Monolithcreative/ES4D/ES4D-2UC.png

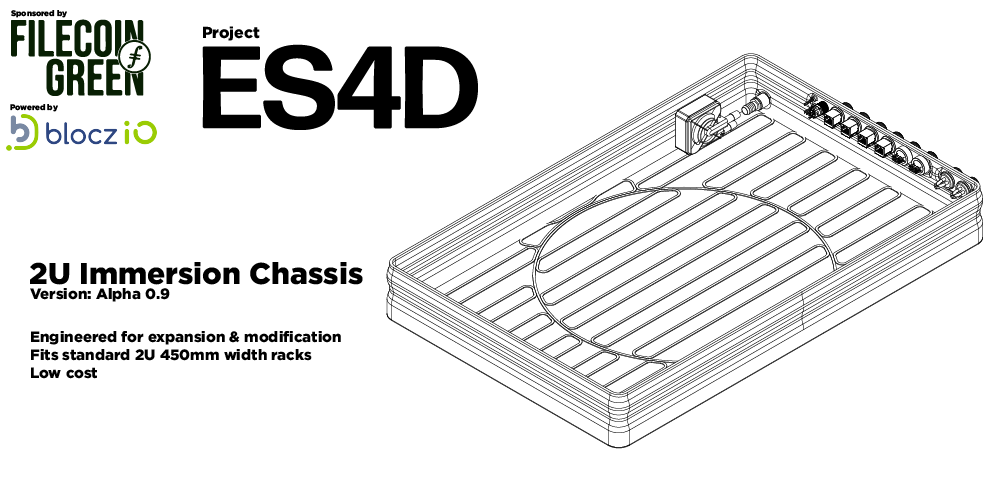
ES4D-2UC.png
