Monolithcreative/ES4D/ES4D-8UR.png

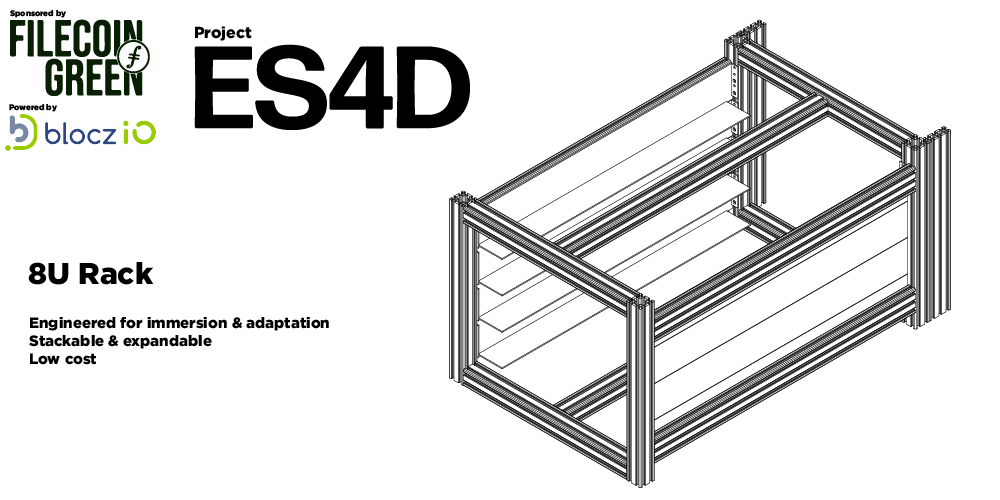
ES4D-8UR.png
