Monolithcreative/ES4D/ES4D.png

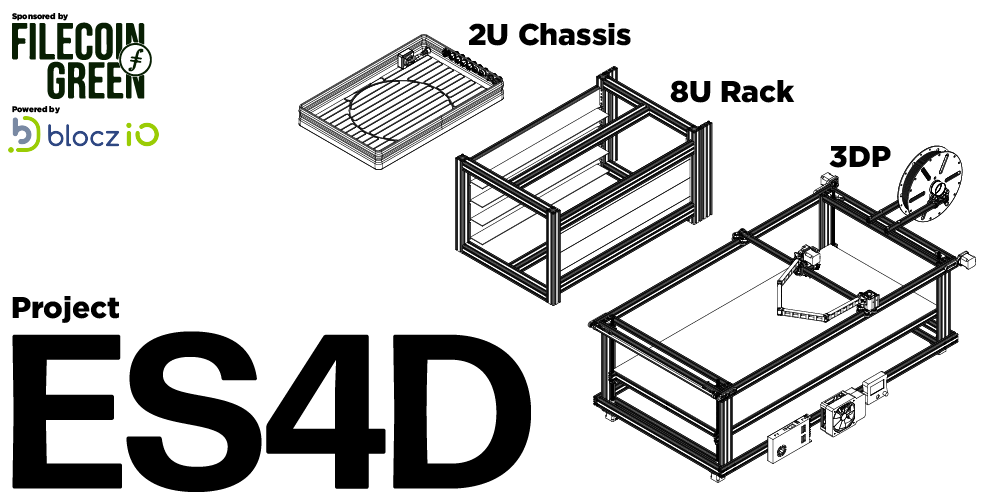
ES4D.png
