Monolithcreative/ES4D/ES4D_3DP_V1.1_BOM.pdf

ES4D 3DP V2 Bill of Materials - Server Chassis Printer

Mechanical (Scalable) | Size (mm)/Desc.
Alu 2020 | 300 | Ooznest (https://ooznest.co.uk/product/v-slot-linear-rail-20x20mm-cut-to-size/) | £ | 2.33 | 2 £ | 4.66
Alu 2020 | 626 | Ooznest (https://ooznest.co.uk/product/v-slot-linear-rail-20x20mm-cut-to-size/) | £ | 5.41 | 4 £ 21.64
Alu 2020 | 670 | Ooznest (https://ooznest.co.uk/product/v-slot-linear-rail-20x20mm-cut-to-size/) | £ | 5.79 | 1 £ | 5.79
Alu 2040 | 560 | Ooznest (https://ooznest.co.uk/product/v-slot-linear-rail-20x40mm-cut-to-size/) | £ | 7.06 | 2 £ 14.12
Alu 2040 | 666 | Ooznest (https://ooznest.co.uk/product/v-slot-linear-rail-20x40mm-cut-to-size/) | £ 10.07 | 4 £ 40.28
Alu 2040 | 1240 | Ooznest (https://ooznest.co.uk/product/v-slot-linear-rail-20x40mm-cut-to-size/) | £ 18.75 | 2 £ 37.50
Alu 2040 | 1300 | Ooznest (https://ooznest.co.uk/product/v-slot-linear-rail-20x40mm-cut-to-size/) | £ 19.66 | 2 £ 39.32
Alu 2060 | 400 | Ooznest (https://ooznest.co.uk/product/v-slot-linear-rail-20x60mm-cut-to-size/) | £ | 8.06 | 4 £ 32.24
Alu rod | 730 x 8 | DIY Store | £ 12.00 | 1 £ 12.00
Buildplate | 1200 x 500 x 4 | Matals4U (https://www.metals4u.co.uk/materials/aluminium/aluminium-sheet/aluminium-mill-finish-aluminium-sheet/9069-p) £ 71.96 | 2 £ 143.92
£ 351.47
Electrical
Contoller | Amazon (https://www.amazon.co.uk/dp/B094NG4D17?s=computers&sp_csd=d2lkZ2V0TmFtZT1zcF9kZXRhaWw) | £ 59.99 | 1 £ 59.99
LCD Screen | Amazon (https://www.amazon.co.uk/BIGTREETECH-Mini12864-intelligent-backlight-suitable/dp/B08N693VQN) | £ 24.99 | 1 £ 24.99
4pcs Stepper Drivers | Amazon (https://www.amazon.co.uk/KINGPRINT-TMC5160-Stepper-StepStick-Heatsink/dp/B07Q1HRN17) | £ 68.99 | 2 £ 137.98
5pcs Nema17 2A Motors | Amazon (https://www.amazon.co.uk/Beautystar-Stepper-Bipolar-Mounting-Brackets/dp/B075SYWFJM) | £ 46.99 | 2 £ 93.98
Power Supply | 12V 1000W | Amazon (https://www.amazon.co.uk/MOGOULUA-Switching-1000W-12V-Transformer/dp/B09Y5DKV6B?s=industrial) | £ 59.99 | 1 £ 59.99
2pcs Lead Screws | Amazon (https://www.amazon.co.uk/iYueshare-100mm-800mm-Printer-Linear/dp/B099WGDWW3) | £ 19.99 | 1 £ 19.99
Belt | Amazon (https://www.amazon.co.uk/gp/product/B07YD5SBD9/ref=ppx_yo_dt_b_search_asin_title?ie=UTF8&psc=1) | £ 13.98 | 2 £ 27.96
5mm Pulley Gear | 20T | Amazon (https://www.amazon.co.uk/Saipor-Aluminum-Synchronous-Compatible-Printer/dp/B084KLTS84) | £ | 6.49 | 1 £ | 6.49
8mm Pulley Gear | 40T | Amazon (https://www.amazon.co.uk/Timing-Pulley-Synchronous-Aluminium-Printer/dp/B07X6M45DJ?s=industrial) | £ | 7.59 | 1 £ | 7.59
8mm Pulley Gear | 60T | Amazon (https://www.amazon.co.uk/sourcing-map-Aluminium-Synchronous-Printer/dp/B09VPR1N1S) | £ | 6.93 | 4 £ 27.72
10pcs Endstops | Amazon (https://www.amazon.co.uk/dp/B08XNG49MW?s=diy&sp_csd=d2lkZ2V0TmFtZT1zcF9kZXRhaWw) | £ 13.99 | 1 £ 13.99
Spacers | Amazon (https://www.amazon.co.uk/dp/B08FRJSQ3Q?s=industrial&sp_csd=d2lkZ2V0TmFtZT1zcF9kZXRhaWwy) | £ 11.99 | 1 £ 11.99
Coupler | Amazon (https://www.amazon.co.uk/UniTak3D-Coupler-Coupling-Printer-Machine/dp/B096G1GZH5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) | £ 11.98 | 2 £ 23.96
Hotend | Amazon (https://www.amazon.co.uk/dp/B0BQYR2TPV/?coliid=I2QIFLH1Q9VK75&colid=2YCJ0P2LP918P) | £ 51.91 | 1 £ 51.91
Mount | Amazon (https://www.amazon.co.uk/dp/B09B2LPBJF/?coliid=IIJJVT6UKROH8&colid=2YCJ0P2LP918P) | £ 14.99 | 1 £ 14.99
Geabox | Amazon (https://www.amazon.co.uk/dp/B07W6SW4TN?s=industrial&sp_csd=d2lkZ2V0TmFtZT1zcF9kZXRhaWw) | £ 11.89 | 1 £ 11.89
PID Temp Controller | Amazon (https://www.amazon.co.uk/gp/product/B07N4K2J2N/ref=ppx_yo_dt_b_asin_title_o00_s00?ie=UTF8&psc=1) | £ 22.69 | 1 £ 22.69
Heater Pad | Amazon (https://www.amazon.co.uk/dp/B07RHGXWDZ?s=industrial&sp_csd=d2lkZ2V0TmFtZT1zcF9kZXRhaWw) | £ 26.19 | 2 £ 52.38
£ 670.48

3D Printed
40mm Turbo Fan Mount | | | £ | 0.34 | 1 £ | 0.34
Bearing Holder 2 | | | £ | 0.06 | 4 £ | 0.24
Bearing Z_L | | | £ | 0.12 | 2 £ | 0.24
Bearing Z_R | | | £ | 0.12 | 2 £ | 0.24
Cable Chain Connector 1 | | | £ | 0.06 | 1 £ | 0.06
Cable Chain Connector 2 | | | £ | 0.07 | 1 £ | 0.07
Cable Chain Long | | | £ | 0.36 | 4 £ | 1.44
Controller Case A | | | £ | 1.59 | 1 £ | 1.59
Controller Case B | | | £ | 1.02 | 1 £ | 1.02
End Bearing Holder A | | | £ | 0.14 | 2 £ | 0.28
End Bearing Holder B | | | £ | 0.13 | 2 £ | 0.26
Extruder A | | | £ | 0.71 | 1 £ | 0.71
Extruder B | | | £ | 0.56 | 1 £ | 0.56
Gantry X | | | £ | 0.30 | 1 £ | 0.30
Gantry X 2 | | | £ | 0.29 | 1 £ | 0.29
Motor Mount | | | £ | 0.75 | 1 £ | 0.75
Motor Mount 2 | | | £ | 0.33 | 1 £ | 0.33
Motor Mount Z_L | | | £ | 0.34 | 2 £ | 0.68
Motor Mount Z_R | | | £ | 0.34 | 2 £ | 0.68
Reel Roll | | | £ | 0.90 | 1 £ | 0.90
Reel Roller Side | | | £ | 0.26 | 4 £ | 1.04
Z Spacer | | | £ | 0.05 | 4 £ | 0.20
£ 12.22

Total £ 1,034.17
