Monolithcreative/ES4D/3DP V1.1 Solidworks Files/ES4DReprap_Discount_Full_Graphic_Smart_Controller.SLDPRT

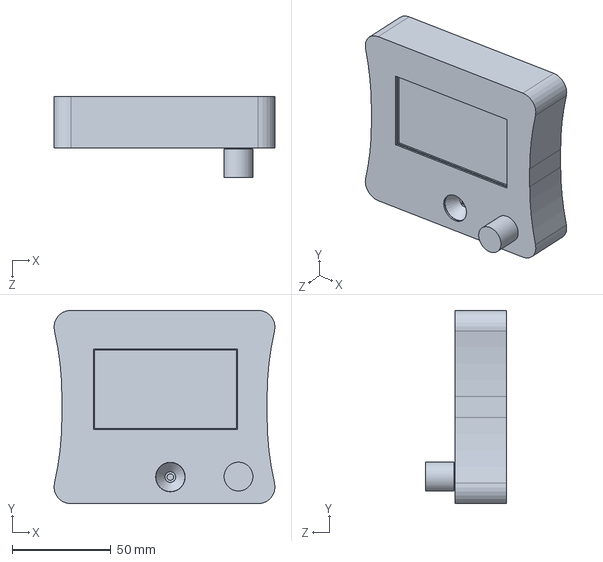
[picture p5: CAD file, 2023-10-12]
3DP V1.1 Solidworks Files/ES4DReprap_Discount_Full_Graphic_Smart_Controller.SLDPRT
112.0 x 98.0 x 41.0 mm
