Monolithcreative/ES4D/3DP V1.1 Solidworks Files/ES4DWheel.SLDPRT

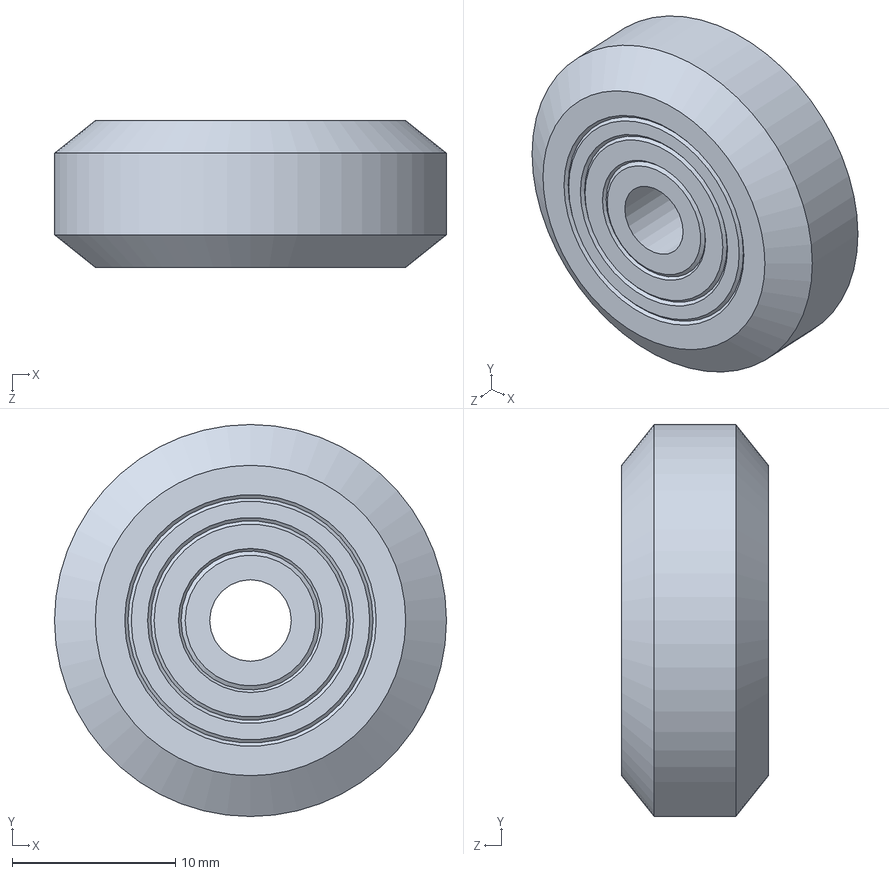
[picture p6: CAD file, 2023-10-12]
3DP V1.1 Solidworks Files/ES4DWheel.SLDPRT
24.0 x 24.0 x 9.00 mm
