Monolithcreative/ES4D/3DP V1.1 Solidworks Files/ES4DZ Spacer.SLDPRT

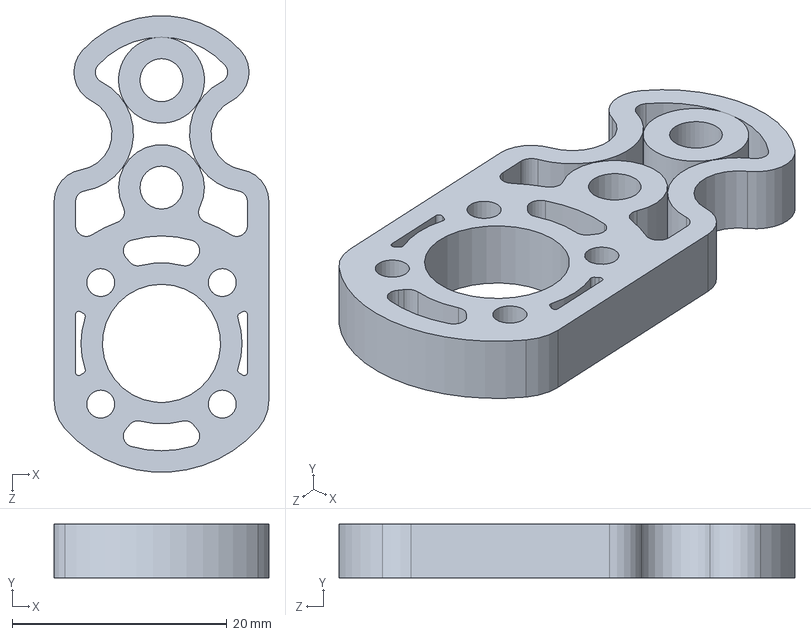
[picture p7: CAD file, 2023-10-12]
3DP V1.1 Solidworks Files/ES4DZ Spacer.SLDPRT
20.0 x 5.00 x 42.4 mm
