Monolithcreative/ES4D/3DP V1.1 Solidworks Files/ES4D600 x 1200 Alu plate.SLDPRT

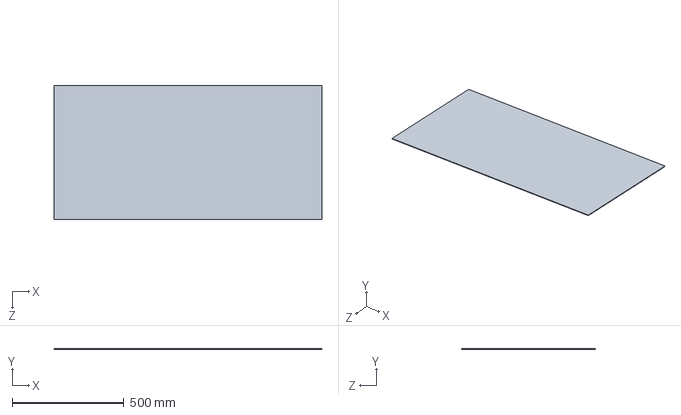
[picture p8: CAD file, 2023-10-12]
3DP V1.1 Solidworks Files/ES4D600 x 1200 Alu plate.SLDPRT
1200.0 x 3.00 x 600.0 mm
