Monolithcreative/ES4D/3DP V1.1 Solidworks Files/ES4DCable Chain Connector 2.SLDPRT

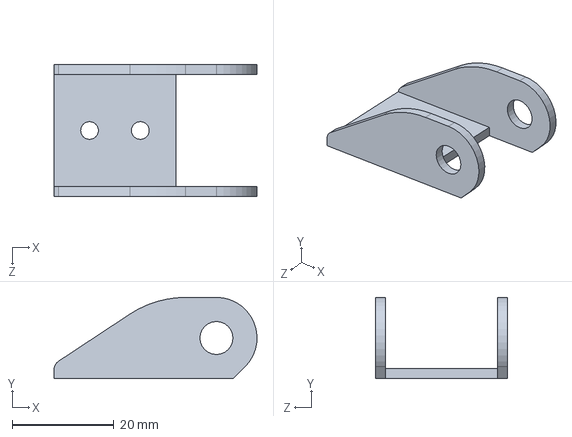
[picture p9: CAD file, 2023-10-12]
3DP V1.1 Solidworks Files/ES4DCable Chain Connector 2.SLDPRT
40.0 x 16.0 x 26.0 mm
