Monolithcreative/ES4D/3DP V1.1 Solidworks Files/ES4DExtruder gearbox.SLDPRT

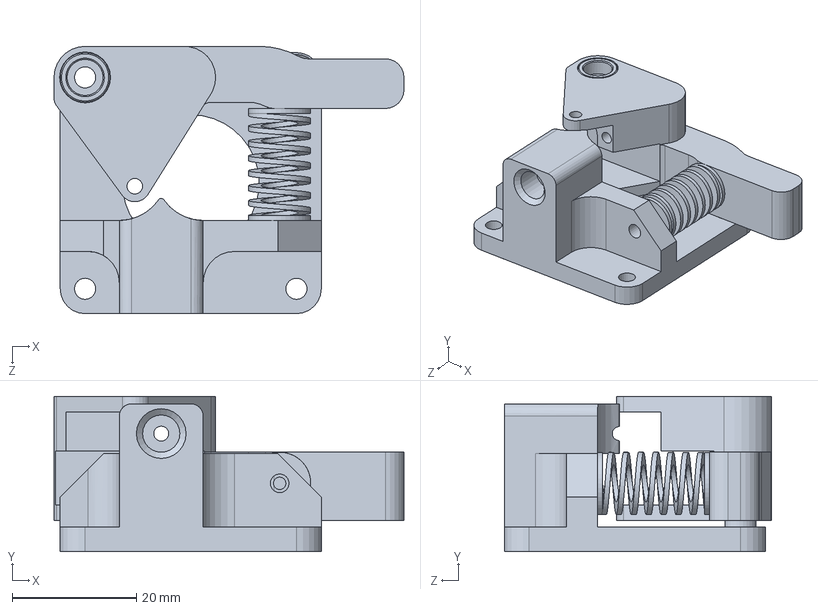
[picture p10: CAD file, 2023-10-12]
3DP V1.1 Solidworks Files/ES4DExtruder gearbox.SLDPRT
56.3 x 25.0 x 43.0 mm
