Monolithcreative/ES4D/3DP V1.1 Solidworks Files/ES4DMotor mount.SLDPRT

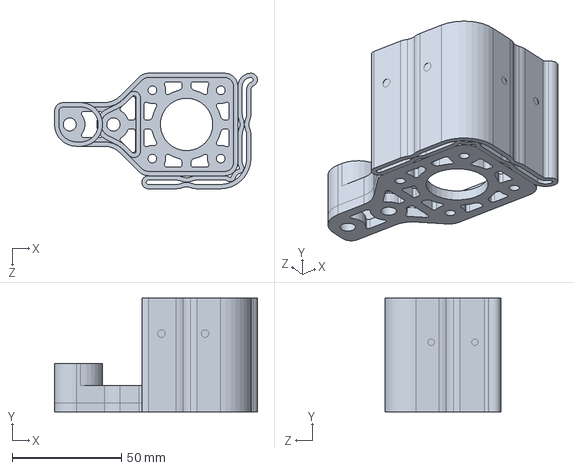
[picture p11: CAD file, 2023-10-12]
3DP V1.1 Solidworks Files/ES4DMotor mount.SLDPRT
93.0 x 52.0 x 53.0 mm
