Monolithcreative/ES4D/3DP V1.1 Solidworks Files/ES4DCable Chain Connector 1.SLDPRT

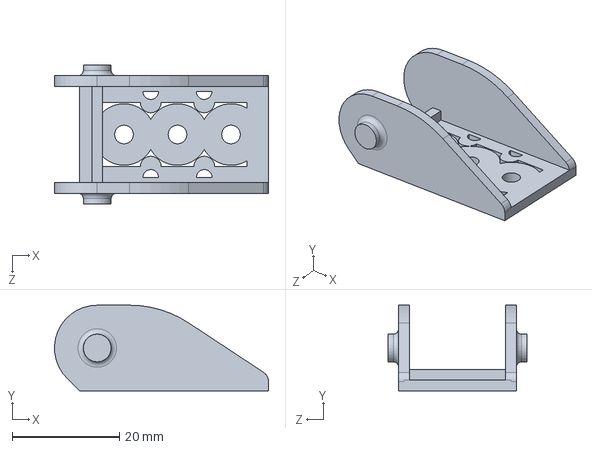
[picture p12: CAD file, 2023-10-12]
3DP V1.1 Solidworks Files/ES4DCable Chain Connector 1.SLDPRT
40.0 x 16.0 x 26.0 mm
