Monolithcreative/ES4D/3DP V1.1 Solidworks Files/ES4DPulley roller.SLDPRT

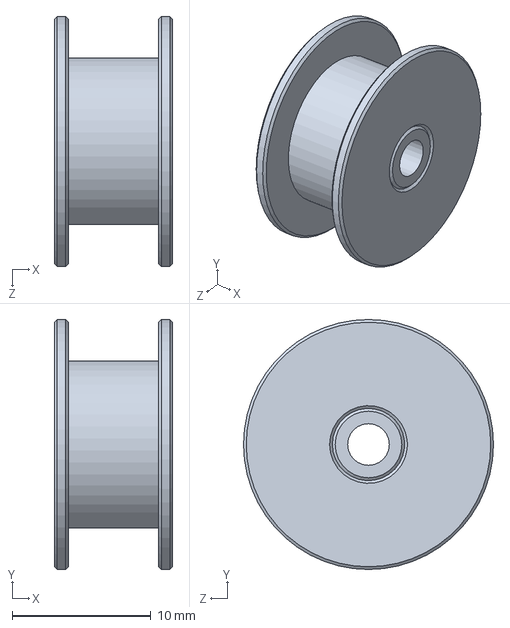
[picture p13: CAD file, 2023-10-12]
3DP V1.1 Solidworks Files/ES4DPulley roller.SLDPRT
8.50 x 18.0 x 18.0 mm
