Monolithcreative/ES4D/3DP V1.1 Solidworks Files/ES4DGantry X 2.SLDPRT

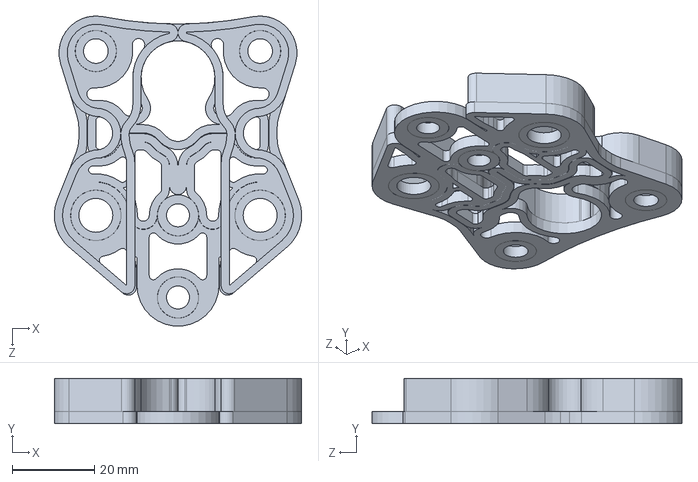
[picture p14: CAD file, 2023-10-12]
3DP V1.1 Solidworks Files/ES4DGantry X 2.SLDPRT
60.2 x 11.0 x 75.5 mm
