Monolithcreative/ES4D/3DP V1.1 Solidworks Files/ES4DCable Chain Long.SLDPRT

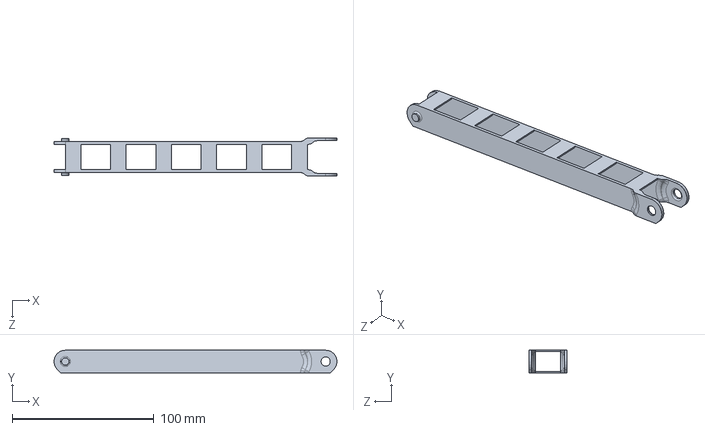
[picture p16: CAD file, 2023-10-12]
3DP V1.1 Solidworks Files/ES4DCable Chain Long.SLDPRT
200.0 x 16.0 x 27.0 mm
