Monolithcreative/ES4D/3DP V1.1 Solidworks Files/ES4D2060 x 400.SLDPRT

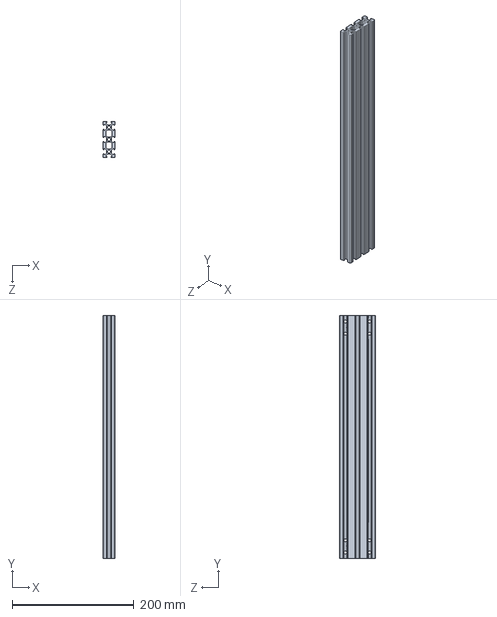
[picture p18: CAD file, 2023-10-12]
3DP V1.1 Solidworks Files/ES4D2060 x 400.SLDPRT
20.0 x 400.0 x 60.0 mm
