Monolithcreative/ES4D/3DP V1.1 Solidworks Files/ES4DEnd Bearing Holder.SLDPRT

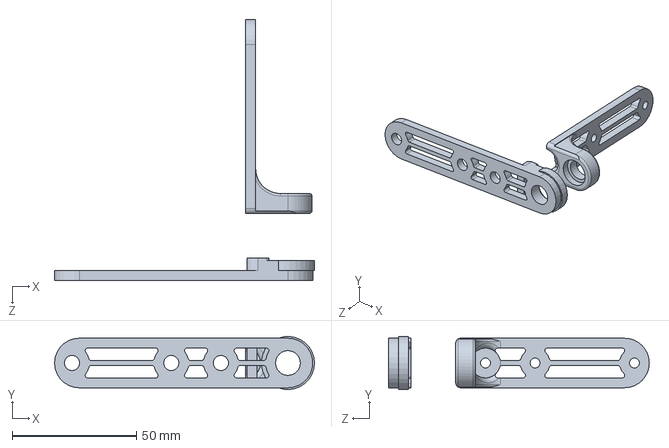
[picture p19: CAD file, 2023-10-12]
3DP V1.1 Solidworks Files/ES4DEnd Bearing Holder.SLDPRT
104.8 x 21.4 x 105.0 mm
