Monolithcreative/ES4D/3DP V1.1 Solidworks Files/ES4D2.3kg reel roller.SLDPRT

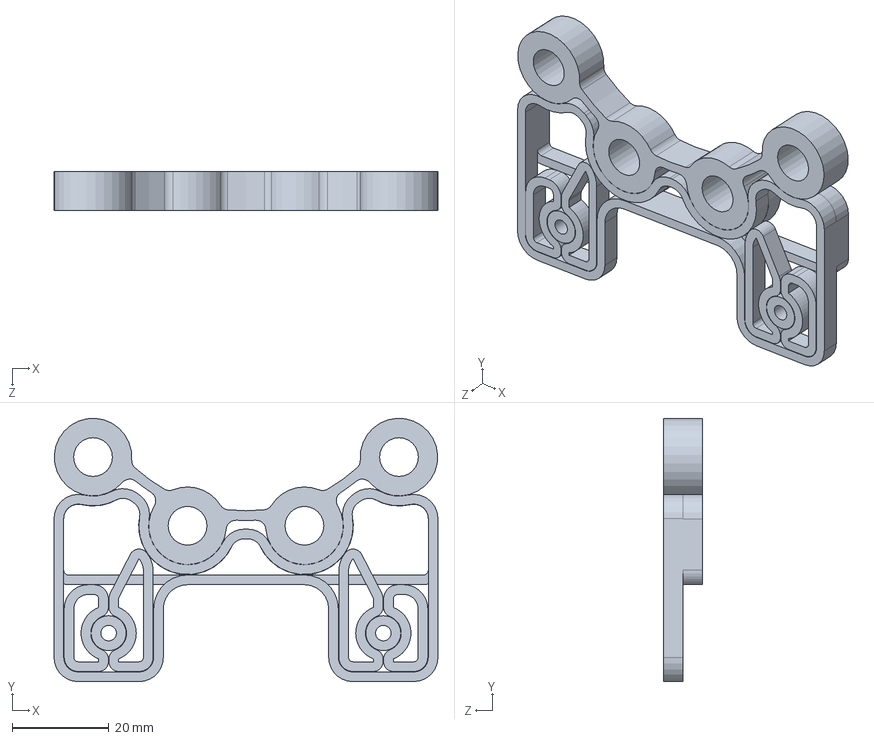
[picture p20: CAD file, 2023-10-12]
3DP V1.1 Solidworks Files/ES4D2.3kg reel roller.SLDPRT
79.2 x 54.3 x 8.00 mm
