Monolithcreative/ES4D/3DP V1.1 Solidworks Files/ES4Dreel roll.sldprt

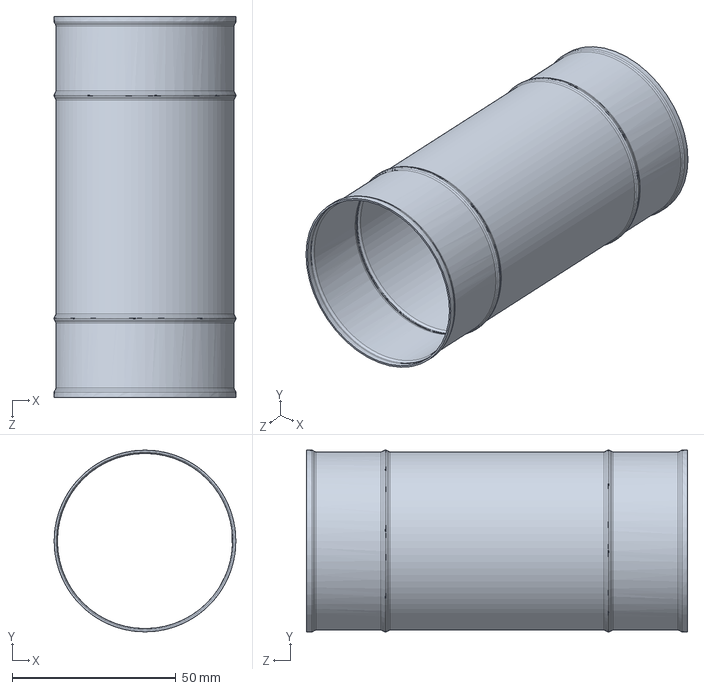
[picture p21: CAD file, 2023-10-12]
3DP V1.1 Solidworks Files/ES4Dreel roll.sldprt
55.4 x 55.4 x 116.2 mm
