Monolithcreative/ES4D/3DP V1.1 Solidworks Files/ES4DGear B.SLDPRT

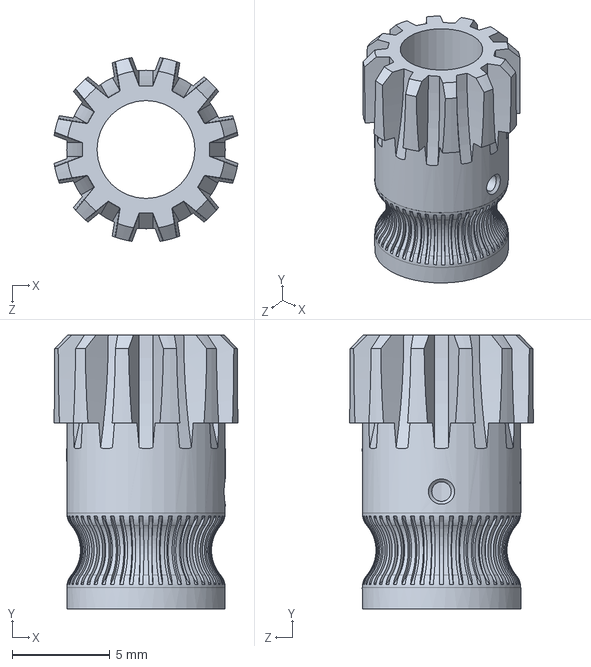
[picture p22: CAD file, 2023-10-12]
3DP V1.1 Solidworks Files/ES4DGear B.SLDPRT
9.39 x 14.0 x 9.39 mm
