Monolithcreative/ES4D/3DP V1.1 Solidworks Files/ES4DExtruder.SLDPRT

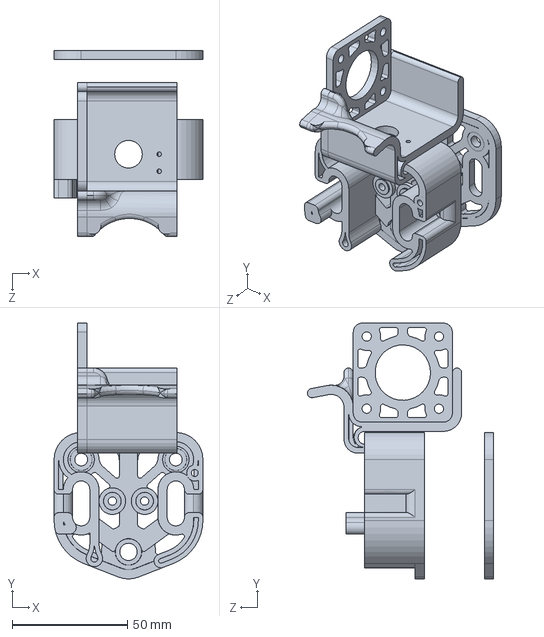
[picture p24: CAD file, 2023-10-12]
3DP V1.1 Solidworks Files/ES4DExtruder.SLDPRT
64.5 x 110.9 x 80.7 mm
