Monolithcreative/ES4D/3DP V1.1 Solidworks Files/ES4DBearing.SLDPRT

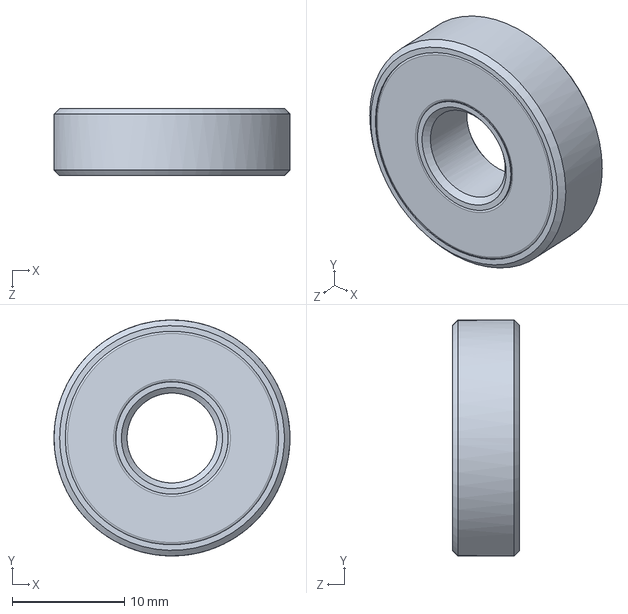
[picture p25: CAD file, 2023-10-12]
3DP V1.1 Solidworks Files/ES4DBearing.SLDPRT
21.0 x 21.0 x 6.00 mm
