Monolithcreative/ES4D/3DP V1.1 Solidworks Files/ES4D2.3kg reel.SLDPRT

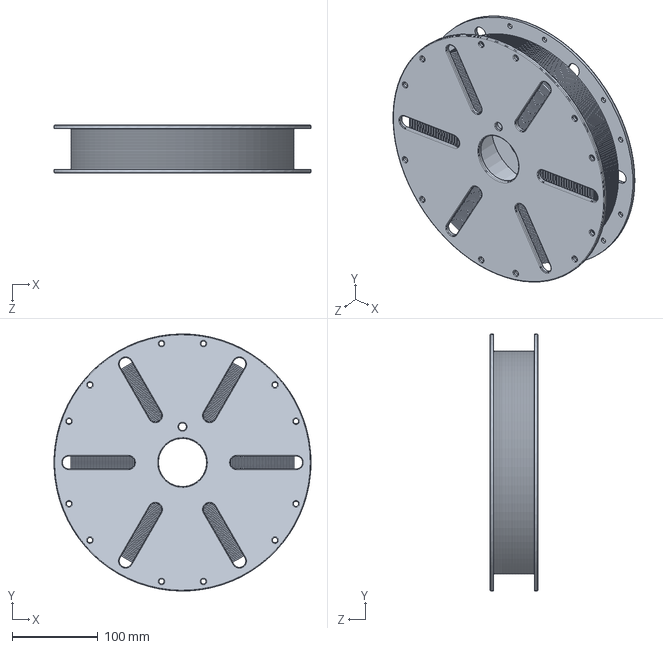
[picture p27: CAD file, 2023-10-12]
3DP V1.1 Solidworks Files/ES4D2.3kg reel.SLDPRT
300.0 x 299.9 x 56.0 mm
