Monolithcreative/ES4D/3DP V1.1 Solidworks Files/ES4DCoupler.SLDPRT

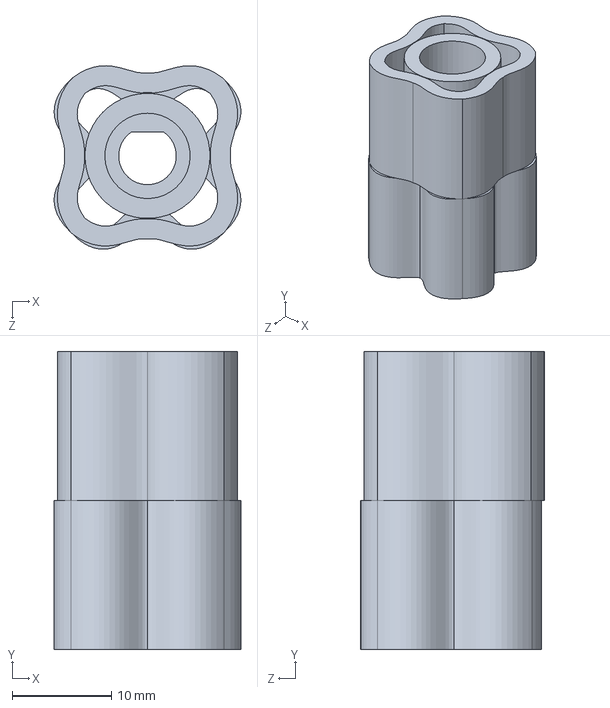
[picture p28: CAD file, 2023-10-12]
3DP V1.1 Solidworks Files/ES4DCoupler.SLDPRT
18.8 x 30.0 x 18.5 mm
