Monolithcreative/ES4D/3DP V1.1 Solidworks Files/ES4DController case V2.SLDPRT

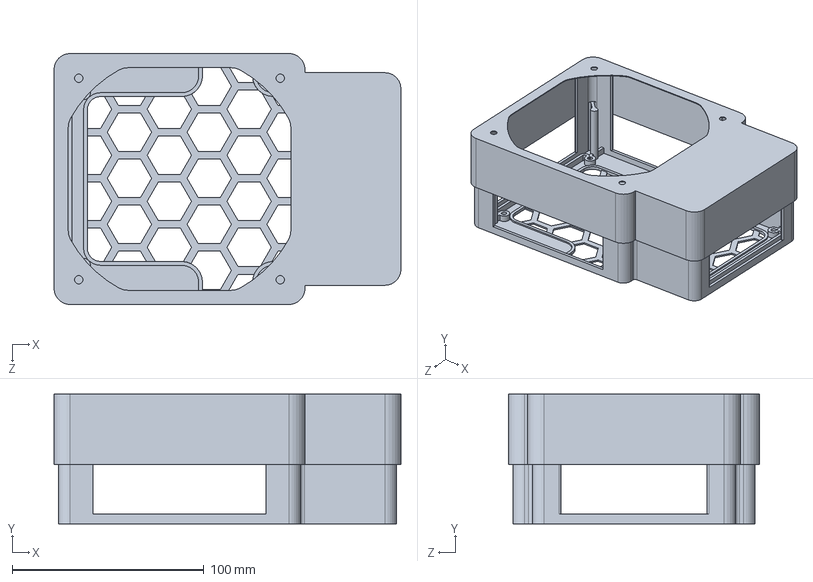
[picture p29: CAD file, 2023-10-12]
3DP V1.1 Solidworks Files/ES4DController case V2.SLDPRT
180.8 x 67.5 x 130.8 mm
