Monolithcreative/ES4D/3DP V1.1 Solidworks Files/ES4DGantry X.SLDPRT

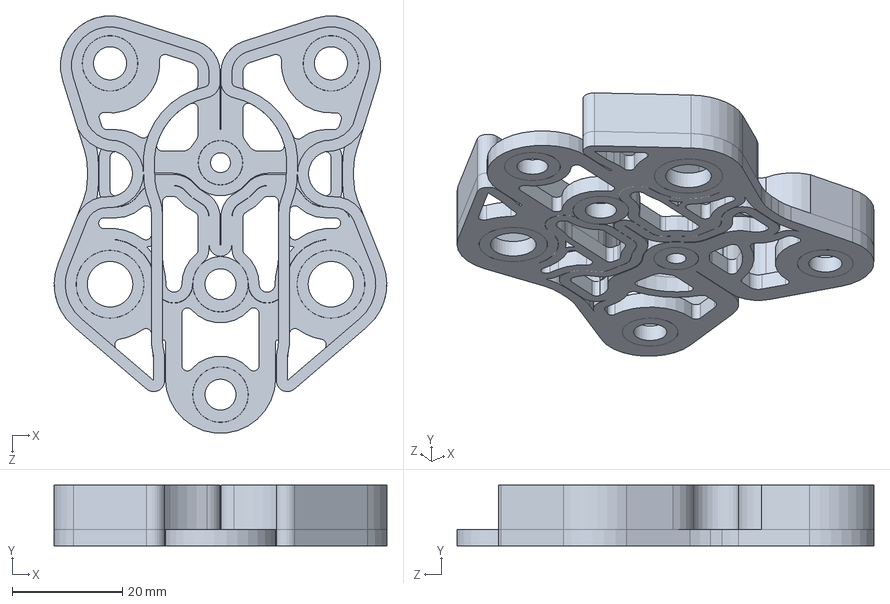
[picture p30: CAD file, 2023-10-12]
3DP V1.1 Solidworks Files/ES4DGantry X.SLDPRT
60.2 x 11.0 x 75.5 mm
