Monolithcreative/ES4D/3DP V1.1 Solidworks Files/ES4DM5 Spacer.SLDPRT

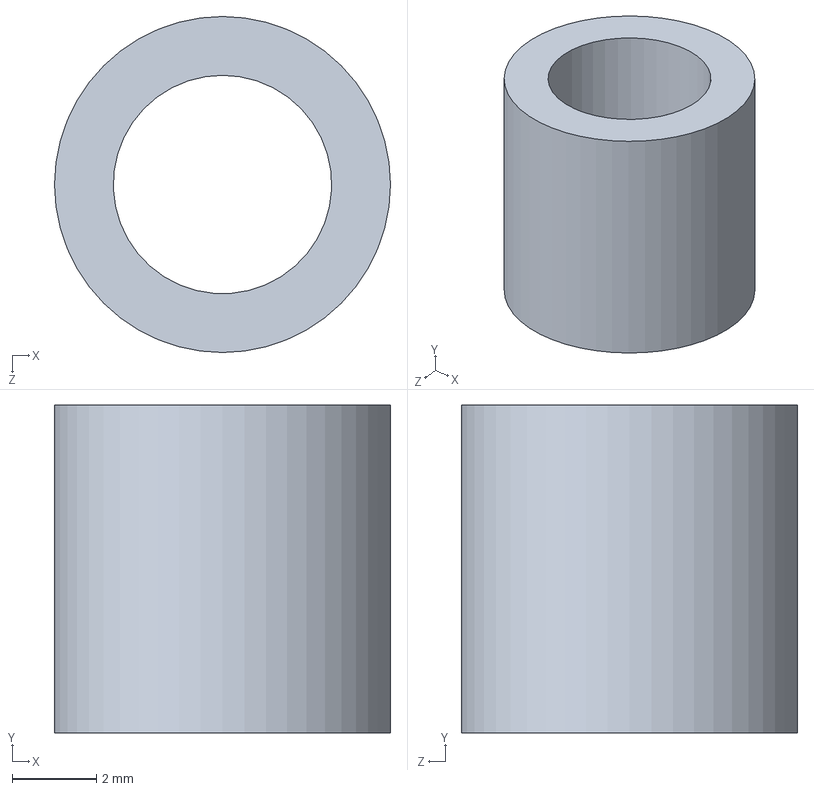
[picture p31: CAD file, 2023-10-12]
3DP V1.1 Solidworks Files/ES4DM5 Spacer.SLDPRT
8.00 x 7.80 x 8.00 mm
