Monolithcreative/ES4D/3DP V1.1 Solidworks Files/ES4DMotor mount Z_R.SLDPRT

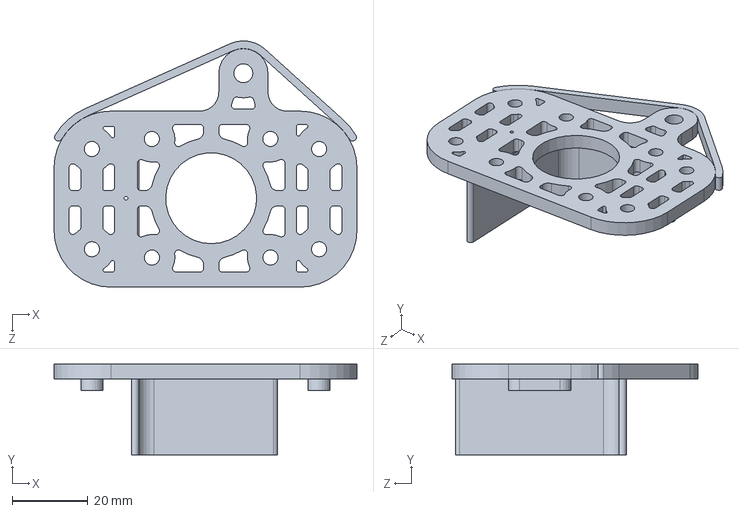
[picture p32: CAD file, 2023-10-12]
3DP V1.1 Solidworks Files/ES4DMotor mount Z_R.SLDPRT
80.0 x 24.0 x 65.0 mm
