Monolithcreative/ES4D/3DP V1.1 Solidworks Files/ES4D40mm Turbo Fan.SLDPRT

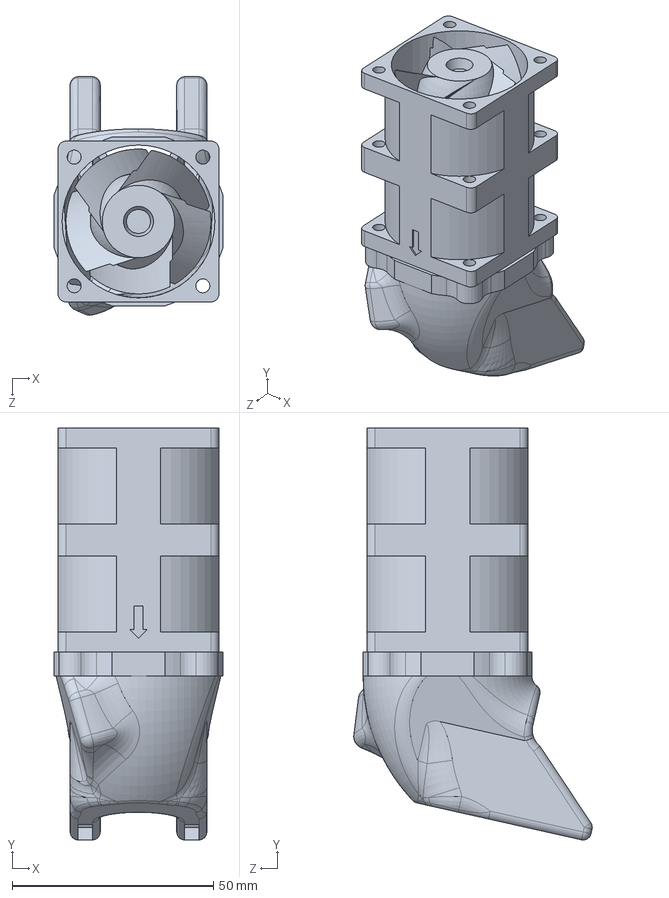
[picture p33: CAD file, 2023-10-12]
3DP V1.1 Solidworks Files/ES4D40mm Turbo Fan.SLDPRT
42.0 x 102.5 x 59.3 mm
