Monolithcreative/ES4D/3DP V1.1 Solidworks Files/ES4DNEMA17.SLDPRT

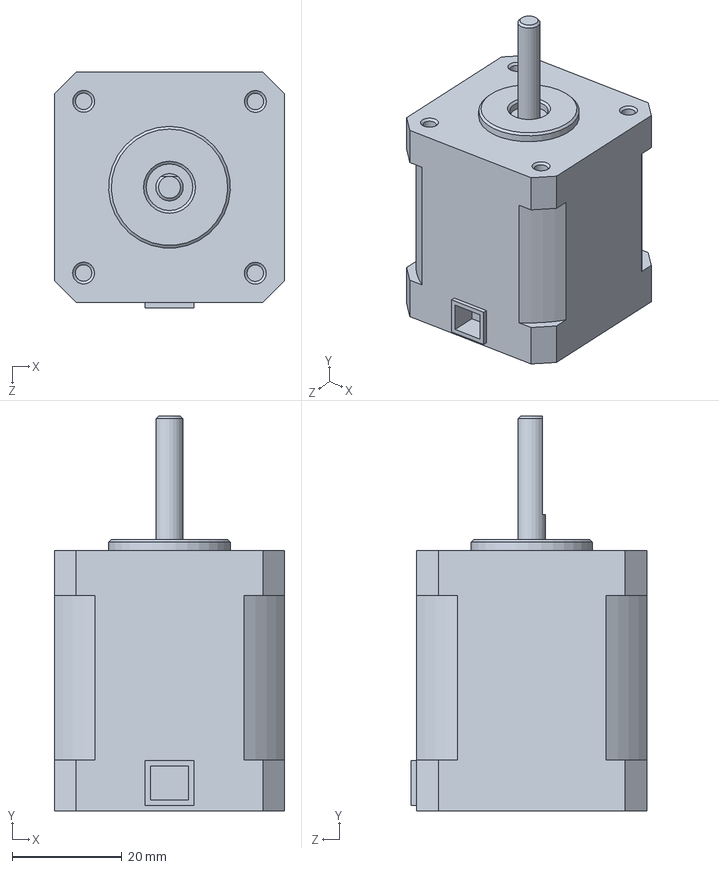
[picture p34: CAD file, 2023-10-12]
3DP V1.1 Solidworks Files/ES4DNEMA17.SLDPRT
42.0 x 72.0 x 43.0 mm
