Monolithcreative/ES4D/3DP V1.1 Solidworks Files/ES4DBearing Z_R.SLDPRT

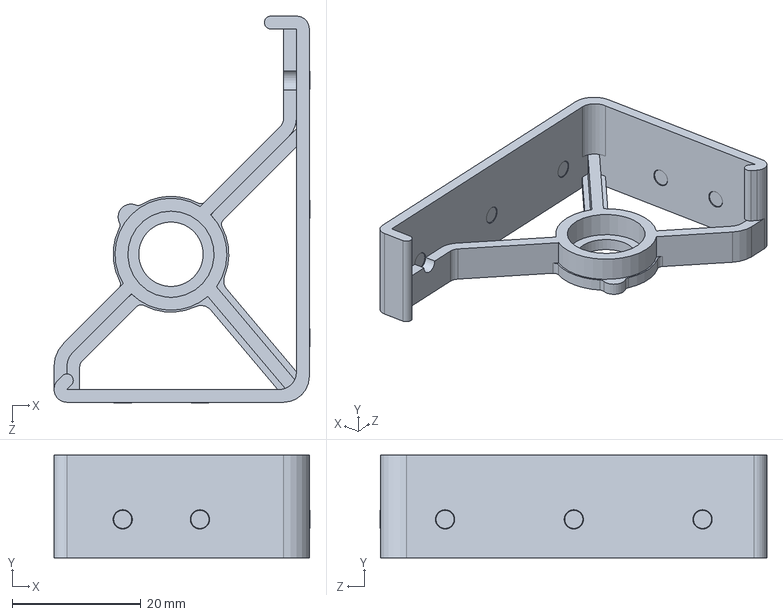
[picture p35: CAD file, 2023-10-12]
3DP V1.1 Solidworks Files/ES4DBearing Z_R.SLDPRT
39.8 x 16.0 x 60.1 mm
