Monolithcreative/ES4D/3DP V1.1 Solidworks Files/ES4DBL-touch.SLDPRT

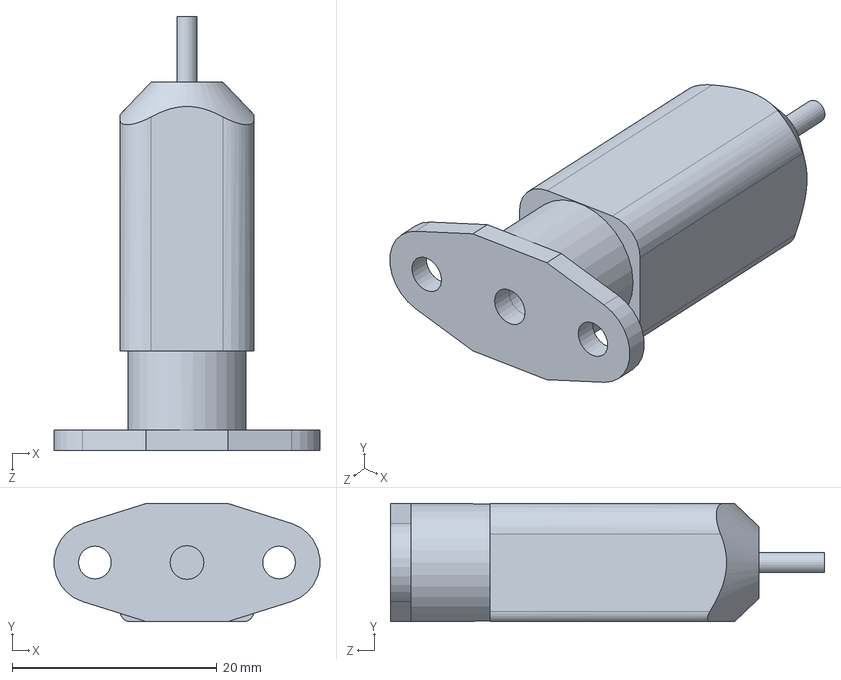
[picture p36: CAD file, 2023-10-12]
3DP V1.1 Solidworks Files/ES4DBL-touch.SLDPRT
25.9 x 11.6 x 42.4 mm
