Monolithcreative/ES4D/3DP V1.1 Solidworks Files/ES4D8 x 730mm Alu rod.SLDPRT

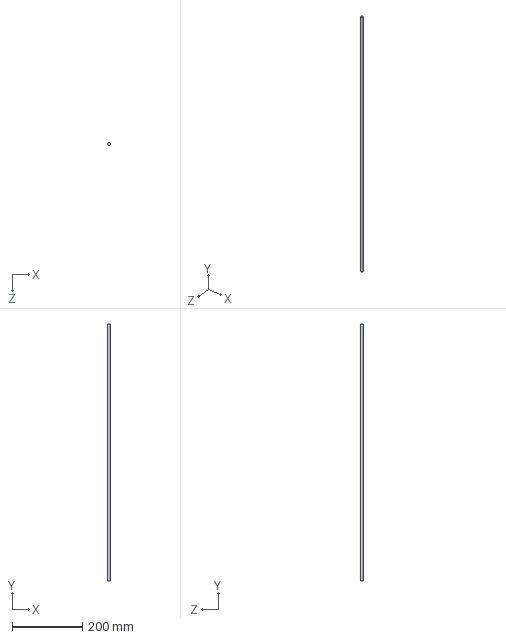
[picture p37: CAD file, 2023-10-12]
3DP V1.1 Solidworks Files/ES4D8 x 730mm Alu rod.SLDPRT
8.00 x 730.0 x 8.00 mm
