Monolithcreative/ES4D/3DP V1.1 Solidworks Files/ES4D2020 x 670.SLDPRT

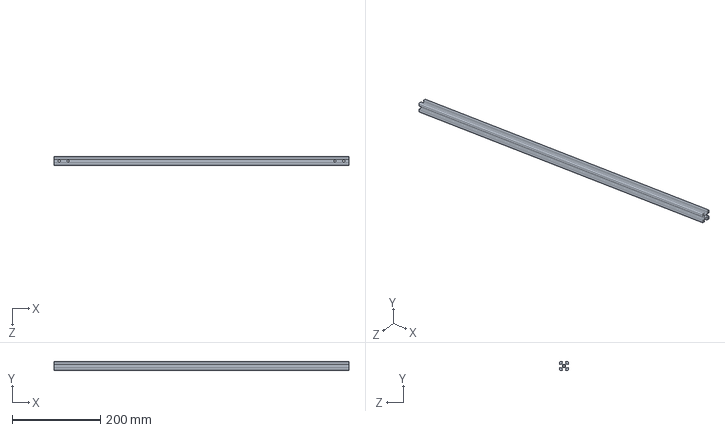
[picture p39: CAD file, 2023-10-12]
3DP V1.1 Solidworks Files/ES4D2020 x 670.SLDPRT
670.0 x 20.0 x 20.0 mm
