Monolithcreative/ES4D/3DP V1.1 Solidworks Files/ES4D1.75mm nozzle.SLDPRT

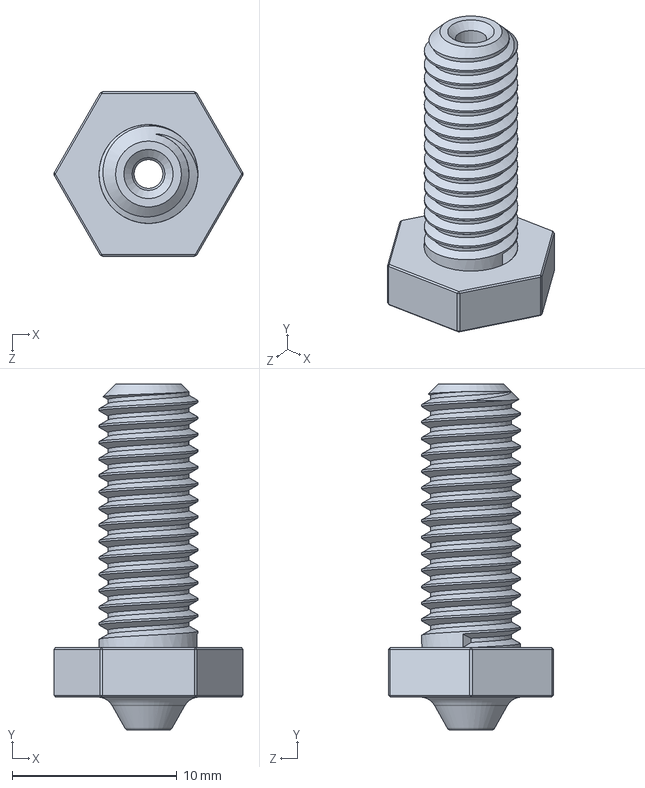
[picture p41: CAD file, 2023-10-12]
3DP V1.1 Solidworks Files/ES4D1.75mm nozzle.SLDPRT
11.4 x 21.0 x 10.0 mm
