Monolithcreative/ES4D/3DP V1.1 Solidworks Files/ES4DMotor mount 2.SLDPRT

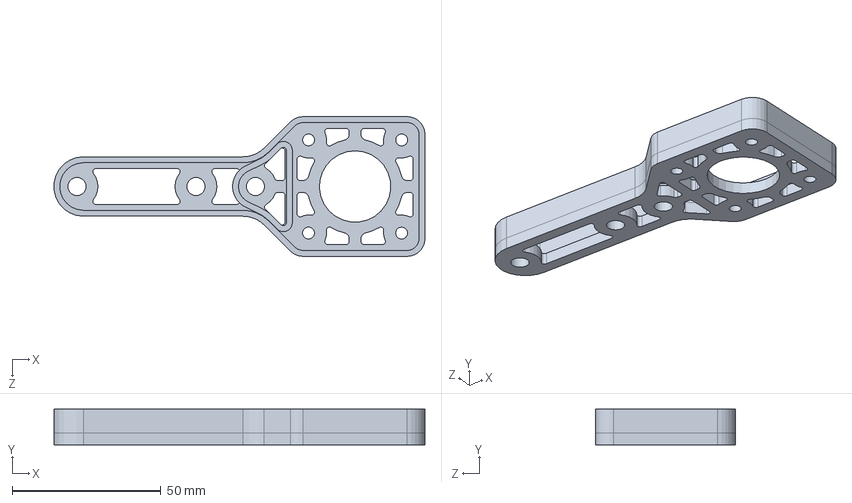
[picture p42: CAD file, 2023-10-12]
3DP V1.1 Solidworks Files/ES4DMotor mount 2.SLDPRT
124.7 x 12.0 x 47.0 mm
