Monolithcreative/ES4D/3DP V1.1 Solidworks Files/ES4DExtruder chamber.SLDPRT

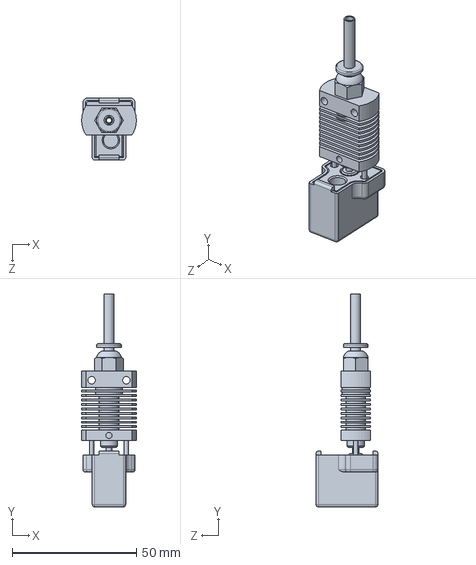
[picture p43: CAD file, 2023-10-12]
3DP V1.1 Solidworks Files/ES4DExtruder chamber.SLDPRT
22.0 x 85.7 x 25.0 mm
