Monolithcreative/ES4D/3DP V1.1 Solidworks Files/ES4DBearing holder 2.SLDPRT

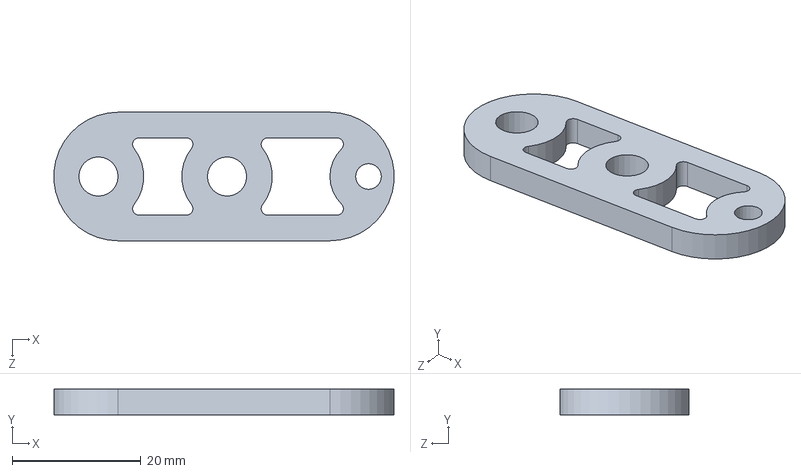
[picture p44: CAD file, 2023-10-12]
3DP V1.1 Solidworks Files/ES4DBearing holder 2.SLDPRT
52.9 x 4.00 x 20.0 mm
