Monolithcreative/ES4D/3DP V1.1 Solidworks Files/ES4D2040 x 666.SLDPRT

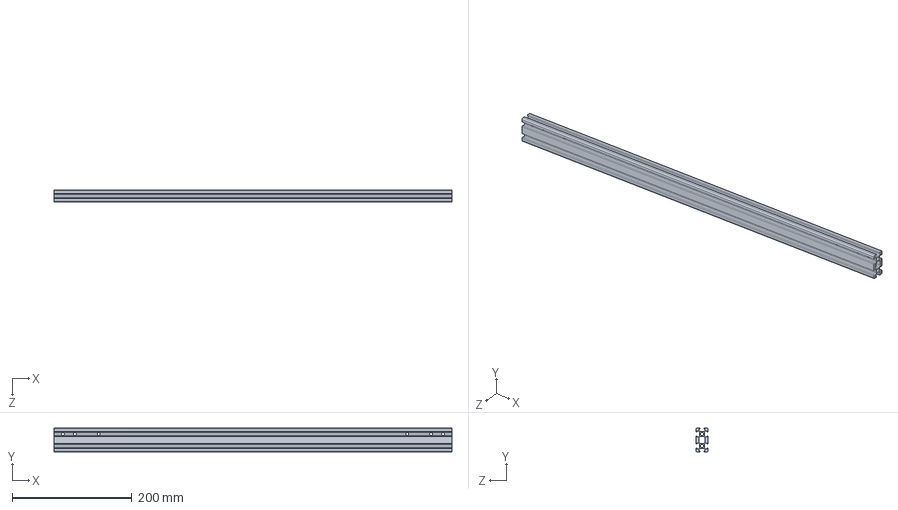
[picture p45: CAD file, 2023-10-12]
3DP V1.1 Solidworks Files/ES4D2040 x 666.SLDPRT
666.0 x 40.0 x 20.0 mm
