Monolithcreative/ES4D/3DP V1.1 Solidworks Files/ES4D2040 x 1300.SLDPRT

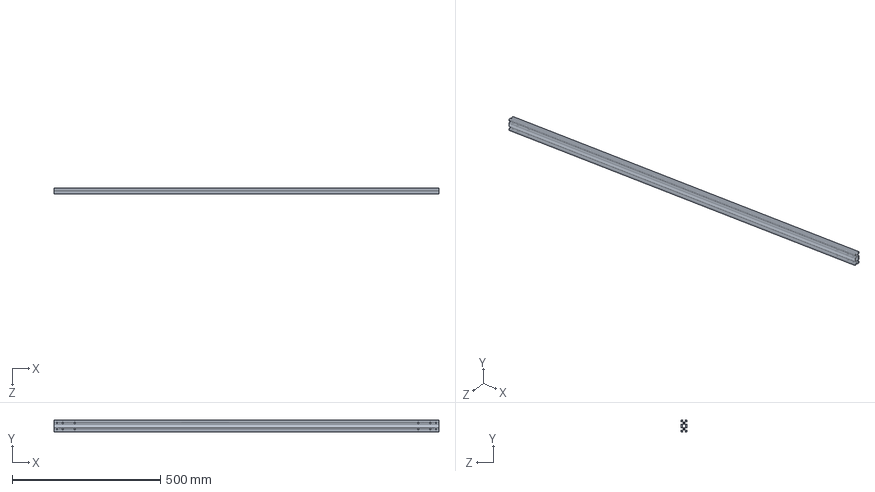
[picture p46: CAD file, 2023-10-12]
3DP V1.1 Solidworks Files/ES4D2040 x 1300.SLDPRT
1300.0 x 40.0 x 20.0 mm
