Monolithcreative/ES4D/3DP V1.1 Solidworks Files/ES4DPulley gear 5mm.SLDPRT

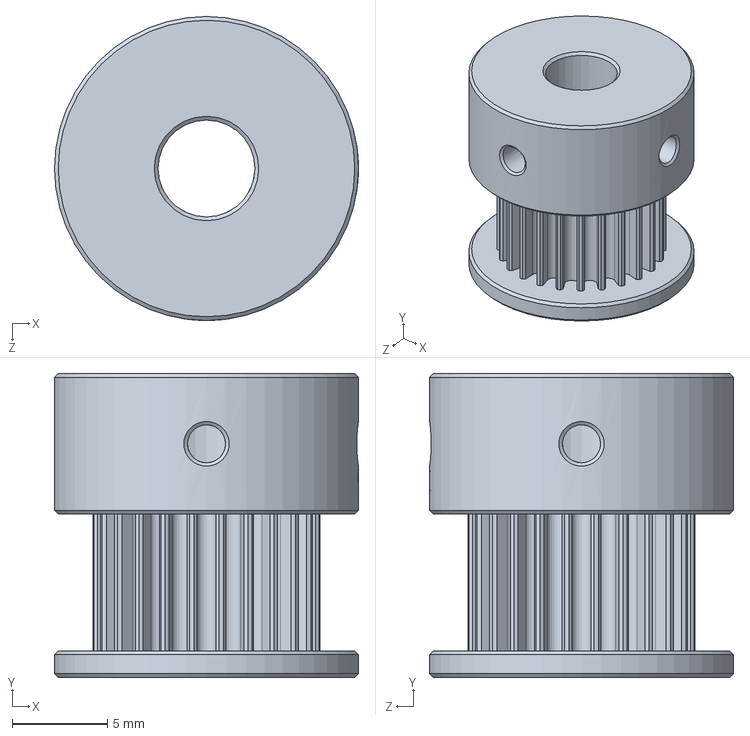
[picture p47: CAD file, 2023-10-12]
3DP V1.1 Solidworks Files/ES4DPulley gear 5mm.SLDPRT
16.0 x 16.0 x 16.0 mm
