Monolithcreative/ES4D/3DP V1.1 Solidworks Files/ES4DZ Carrage Assem.SLDASM

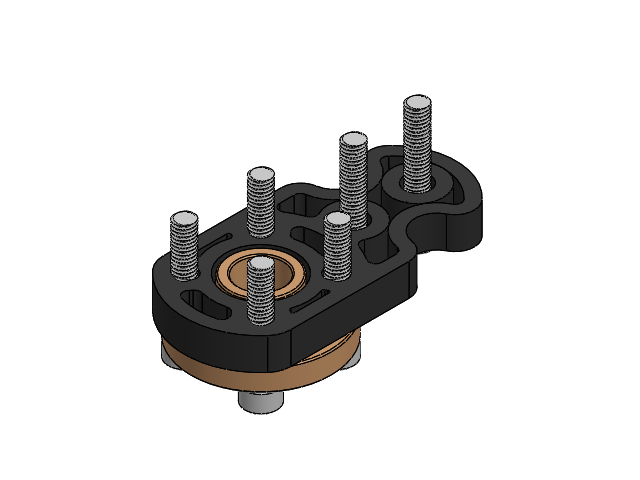
[picture p49: CAD file, 2023-10-12]
3DP V1.1 Solidworks Files/ES4DZ Carrage Assem.SLDASM
ES4DT8 Nut
ES4DZ Spacer
ES4DM3 Bolt 16mm x 6
