Monolithcreative/ES4D/3DP V1.1 Solidworks Files/ES4DSS-5GL_6.sldasm

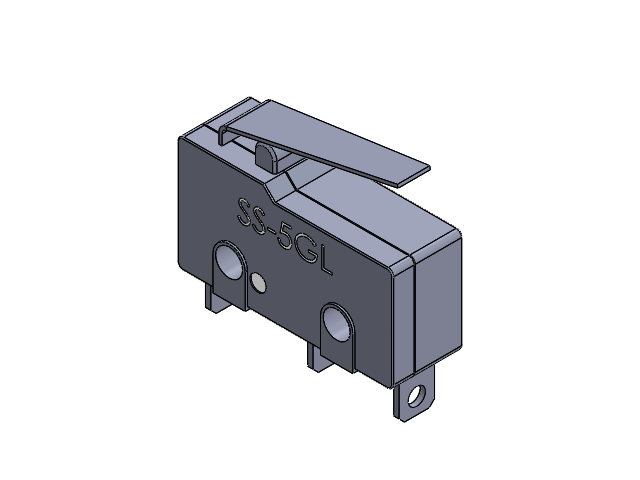
[picture p50: CAD file, 2023-10-12]
3DP V1.1 Solidworks Files/ES4DSS-5GL_6.sldasm
ES4DSS-5GL
ES4DSS-5GL_2
ES4DSS-5GL_4
ES4DSS-5GL_5
ES4DSS-5GL_1
ES4DSS-5GL_3
