Monolithcreative/ES4D/3DP V1.1 Solidworks Files/ES4DNoctua120.SLDASM

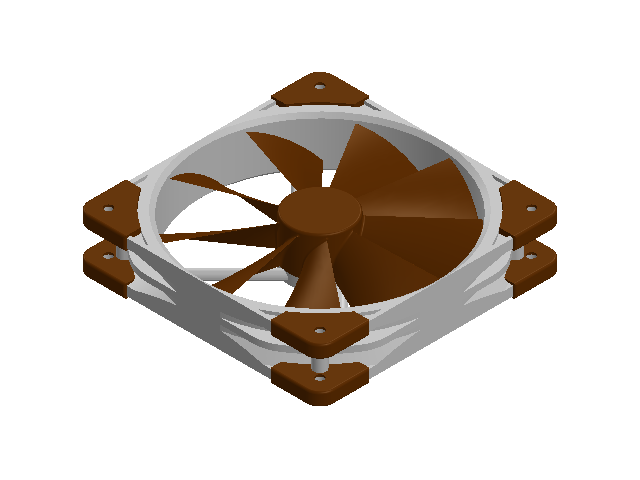
[picture p51: CAD file, 2023-10-12]
3DP V1.1 Solidworks Files/ES4DNoctua120.SLDASM
ES4DFan-Frame
ES4DFan-Fan
ES4DFan-Dempfer x 8
