Monolithcreative/ES4D/3DP V1.1 Solidworks Files/ES4DFrame Assem.SLDASM

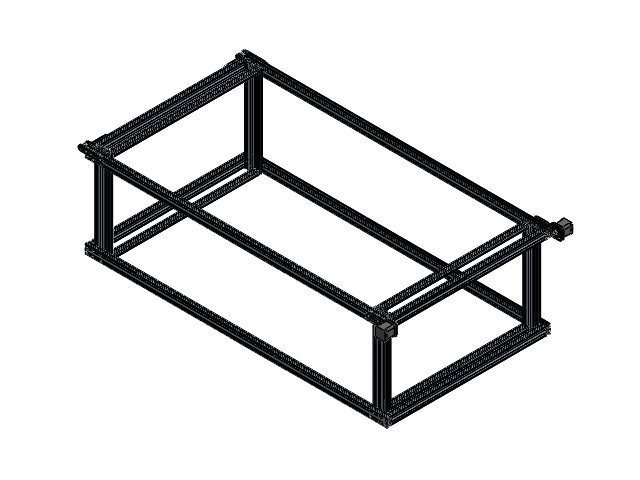
[picture p52: CAD file, 2023-10-12]
3DP V1.1 Solidworks Files/ES4DFrame Assem.SLDASM
ES4D2040 x 666 x 4
ES4D2040 x 1300 x 4
ES4D2060 x 400 x 4
ES4D2020 x 626 x 4
ES4DM5 Bolt 75mm_prop x 24
ES4DM5 Bolt 30mm_prop x 24
ES4DMotor mount 2 x 2
ES4DNEMA17 x 2
ES4DM3 Bolt 8mm x 8
ES4DEnd Bearing Holder x 2
ES4DPulley gear 5mm x 2
ES4DM5 Bolt 15mm_prop x 6
ES4DPulley gear 8mm x 2
