Monolithcreative/ES4D/3DP V1.1 Solidworks Files/ES4DPSU_A_.sldasm

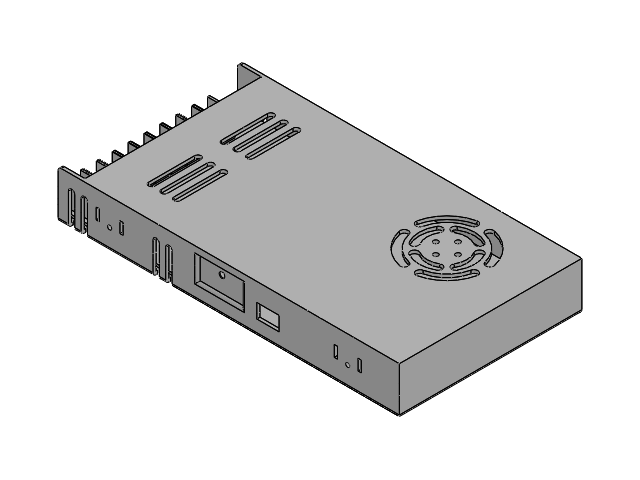
[picture p53: CAD file, 2023-10-12]
3DP V1.1 Solidworks Files/ES4DPSU_A_.sldasm
ES4DSMPS BIG_LRS-350-24_25
ES4DSMPS BIG_LRS-350-24_14
ES4DSMPS BIG_LRS-350-24_18
ES4DSMPS BIG_LRS-350-24_7
ES4DSMPS BIG_LRS-350-24_16
ES4DSMPS BIG_LRS-350-24_9
ES4DSMPS BIG_LRS-350-24_24
ES4DSMPS BIG_LRS-350-24_10
ES4DSMPS BIG_LRS-350-24_2
ES4DSMPS BIG_LRS-350-24_19
ES4DSMPS BIG_LRS-350-24_22
ES4DSMPS BIG_LRS-350-24_1
ES4DSMPS BIG_LRS-350-24_12
ES4DSMPS BIG_LRS-350-24_23
ES4DSMPS BIG_LRS-350-24_13
ES4DSMPS BIG_LRS-350-24_27
ES4DSMPS BIG_LRS-350-24_26
ES4DSMPS BIG_LRS-350-24
ES4DSMPS BIG_LRS-350-24_5
ES4DSMPS BIG_LRS-350-24_6
ES4DSMPS BIG_LRS-350-24_17
ES4DSMPS BIG_LRS-350-24_20
ES4DSMPS BIG_LRS-350-24_28
ES4DSMPS BIG_LRS-350-24_15
ES4DSMPS BIG_LRS-350-24_3
ES4DSMPS BIG_LRS-350-24_8
ES4DSMPS BIG_LRS-350-24_21
ES4DSMPS BIG_LRS-350-24_11
ES4DSMPS BIG_LRS-350-24_4
