Monolithcreative/ES4D/3DP V1.1 Solidworks Files/ES4DGantry X left motor.SLDASM

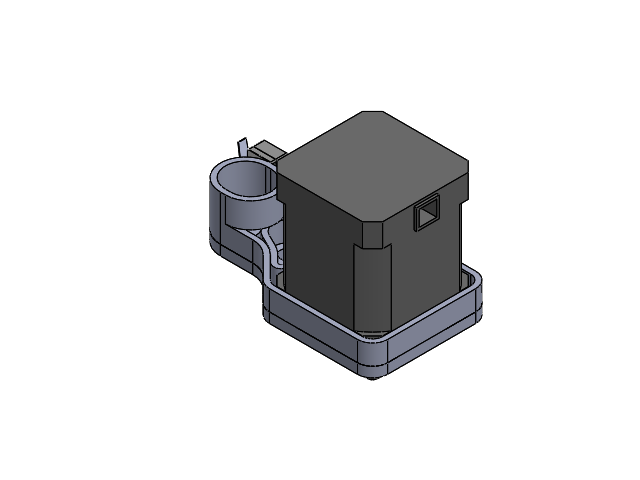
[picture p54: CAD file, 2023-10-12]
3DP V1.1 Solidworks Files/ES4DGantry X left motor.SLDASM
ES4DMotor mount
ES4DNEMA17
ES4DM3 Bolt 8mm x 4
ES4DSS-5GL
ES4DSS-5GL_2
ES4DSS-5GL_4
ES4DSS-5GL_5
ES4DSS-5GL_1
ES4DSS-5GL_3
