Monolithcreative/ES4D/3DP V1.1 Solidworks Files/ES4D40mm_Fan.sldasm

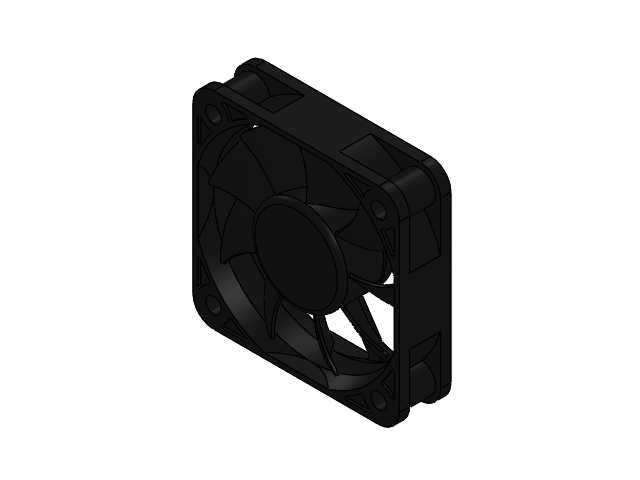
[picture p55: CAD file, 2023-10-12]
3DP V1.1 Solidworks Files/ES4D40mm_Fan.sldasm
ES4D40mmFan v3
ES4D40mmFan v3_1
