Monolithcreative/ES4D/3DP V1.1 Solidworks Files/ES4DExtruder Assem.SLDASM

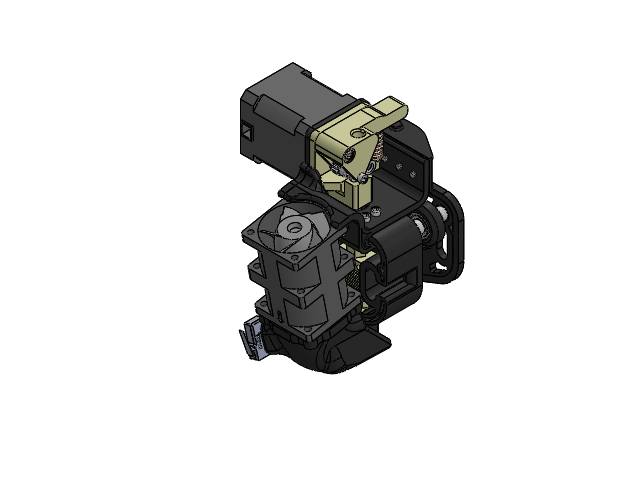
[picture p56: CAD file, 2023-10-12]
3DP V1.1 Solidworks Files/ES4DExtruder Assem.SLDASM
ES4DExtruder
ES4DExtruder chamber
ES4D1.75mm nozzle
ES4DNEMA17
ES4DExtruder gearbox
ES4DGear A
ES4DGear B
ES4DM3 Bolt 16mm x 4
ES4DM3 Bolt 30mm
ES4DCable Chain Connector 1
ES4DM3 Bolt 8mm x 11
ES4DSS-5GL
ES4DSS-5GL_2
ES4DSS-5GL_4
ES4DSS-5GL_5
ES4DSS-5GL_1
ES4DSS-5GL_3
ES4DBL-touch
ES4D40mm Turbo Fan
ES4DWheel x 3
ES4DM5 Offset nut x 2
ES4DM5 Bolt 40mm_prop x 3
ES4DM5 Spacer x 4
