Monolithcreative/ES4D/3DP V1.1 Solidworks Files/ES4DGantry X right carrage.SLDASM

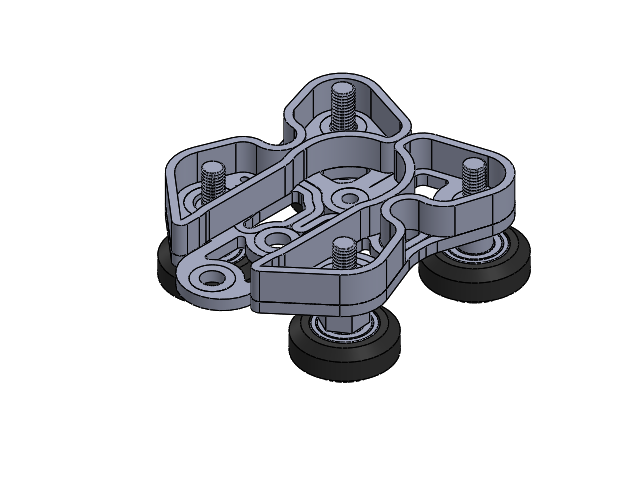
[picture p57: CAD file, 2023-10-12]
3DP V1.1 Solidworks Files/ES4DGantry X right carrage.SLDASM
ES4DGantry X
ES4DM5 Bolt 30mm x 4
ES4DWheel x 4
ES4DM5 Offset nut x 2
ES4DM5 Spacer x 2
