Monolithcreative/ES4D/3DP V1.1 Solidworks Files/ES4DReel Dispenser Assem.SLDASM

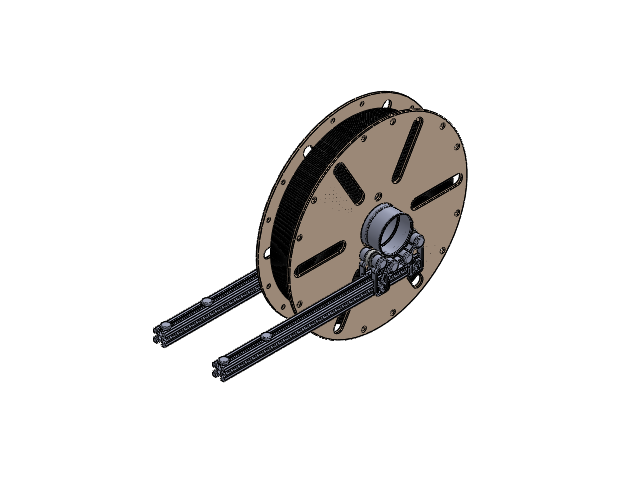
[picture p58: CAD file, 2023-10-12]
3DP V1.1 Solidworks Files/ES4DReel Dispenser Assem.SLDASM
ES4D2.3kg reel roller x 4
ES4Dreel roll
ES4D2020 x 330 x 2
ES4D2.3kg reel
ES4DBearing x 8
ES4DM5 bolt x 12
