Monolithcreative/ES4D/3DP V1.1 Solidworks Files/ES4DBed Assem.SLDASM

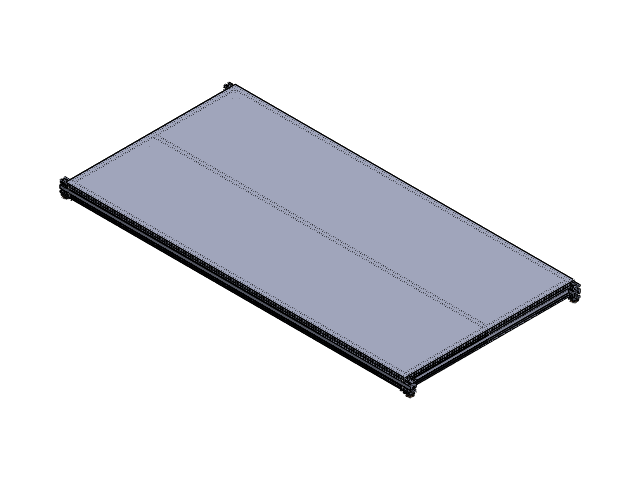
[picture p60: CAD file, 2023-10-12]
3DP V1.1 Solidworks Files/ES4DBed Assem.SLDASM
ES4D2040 x 560 x 2
ES4D600 x 1200 Alu plate
ES4D2040 x 1160
ES4D2040 x 1240 x 2
ES4DM5 Bolt 30mm_prop x 12
ES4DT8 Nut x 4
ES4DZ Spacer x 4
ES4DM3 Bolt 16mm x 24
