Monolithcreative/ES4D/3DP V1.1 Solidworks Files/ES4DGantry X Assem.SLDASM

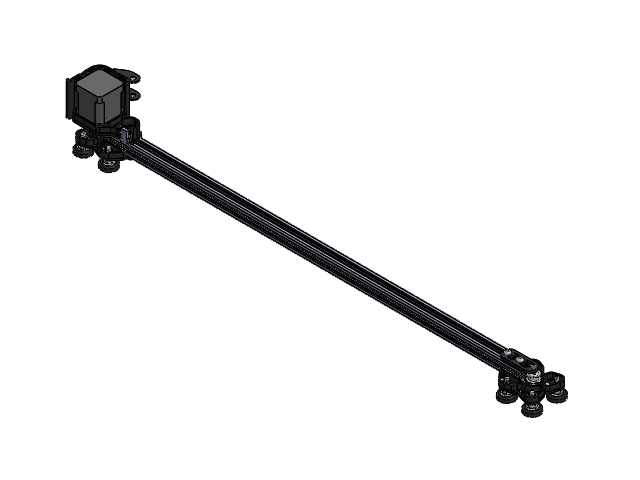
[picture p61: CAD file, 2023-10-12]
3DP V1.1 Solidworks Files/ES4DGantry X Assem.SLDASM
ES4D2020 x 670
ES4DMotor mount
ES4DNEMA17
ES4DM3 Bolt 8mm x 7
ES4DSS-5GL
ES4DSS-5GL_2
ES4DSS-5GL_4
ES4DSS-5GL_5
ES4DSS-5GL_1
ES4DSS-5GL_3
ES4DM5 Bolt 30mm x 12
ES4DWheel x 8
ES4DM5 Offset nut x 4
ES4DM5 Spacer x 4
ES4DGantry X 2
ES4DGantry X
ES4DBearing holder 2
ES4DM3 Bolt 30mm
ES4DPulley roller
ES4DCable Chain Connector 2
