Monolithcreative/ES4D/3DP V1.1 Solidworks Files/ES4DGantry X left carrage.SLDASM

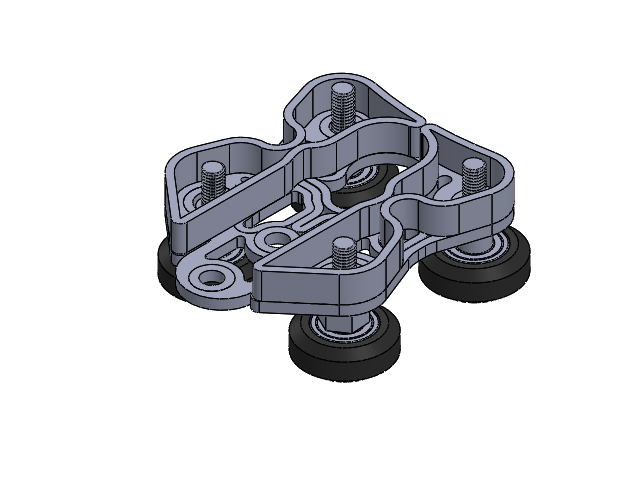
[picture p63: CAD file, 2023-10-12]
3DP V1.1 Solidworks Files/ES4DGantry X left carrage.SLDASM
ES4DM5 Bolt 30mm x 4
ES4DWheel x 4
ES4DM5 Offset nut x 2
ES4DM5 Spacer x 2
ES4DGantry X 2
