Monolithcreative/ES4D/3DP V1.1 Solidworks Files/ES4DM5 Spacer Wheel.SLDASM

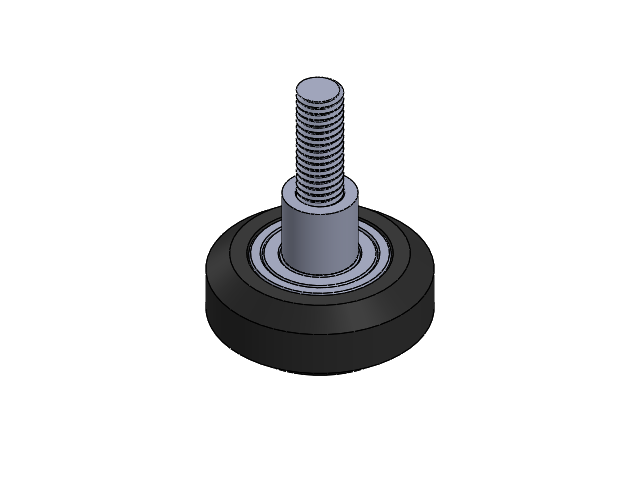
[picture p64: CAD file, 2023-10-12]
3DP V1.1 Solidworks Files/ES4DM5 Spacer Wheel.SLDASM
ES4DM5 Bolt 30mm
ES4DWheel
ES4DM5 Spacer
