Monolithcreative/ES4D/3DP V1.1 Solidworks Files/ES4DGantry Y motor.SLDASM

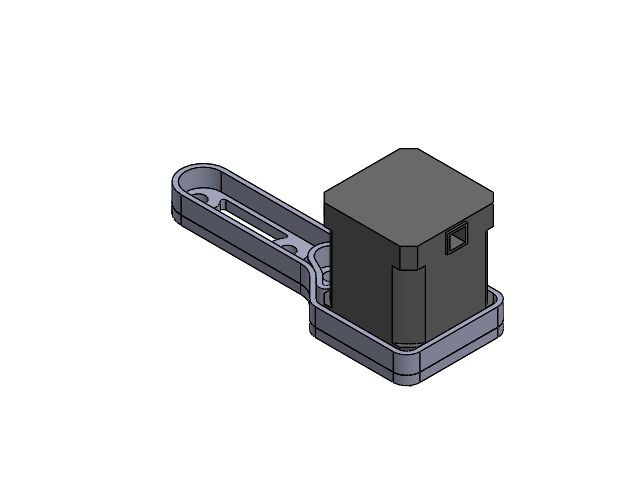
[picture p65: CAD file, 2023-10-12]
3DP V1.1 Solidworks Files/ES4DGantry Y motor.SLDASM
ES4DMotor mount 2
ES4DNEMA17
ES4DM3 Bolt 8mm x 4
