Monolithcreative/ES4D/3DP V1.1 Solidworks Files/ES4DController Assembly.SLDASM

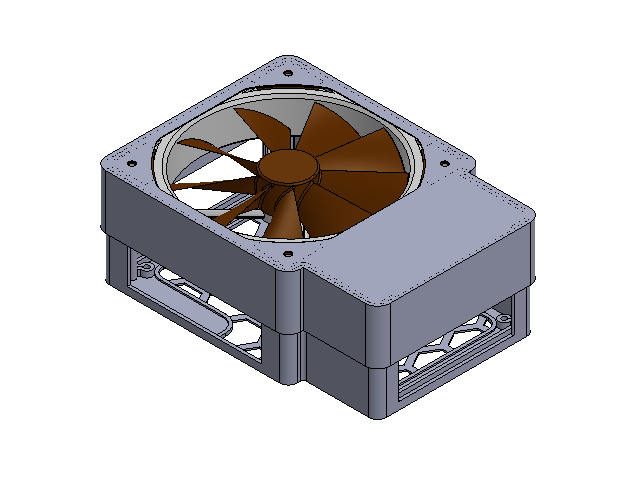
[picture p66: CAD file, 2023-10-12]
3DP V1.1 Solidworks Files/ES4DController Assembly.SLDASM
ES4DController case V2
ES4DFan-Frame
ES4DFan-Fan
ES4DFan-Dempfer x 8
