Monolithcreative/ES4D/3DP V1.1 Solidworks Files/ES4DM5 Two Spacer Wheel.SLDASM

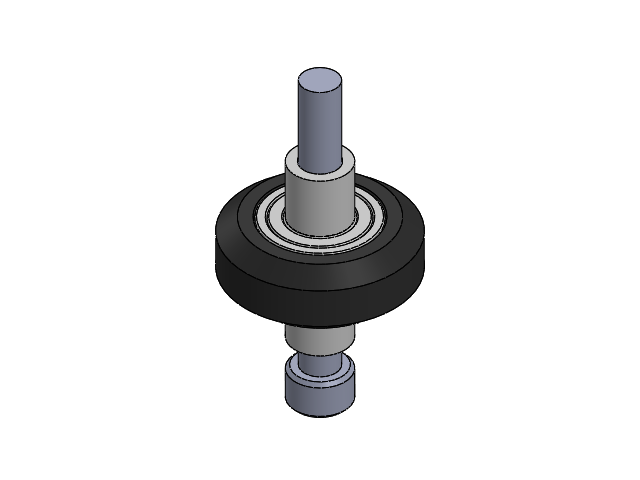
[picture p67: CAD file, 2023-10-12]
3DP V1.1 Solidworks Files/ES4DM5 Two Spacer Wheel.SLDASM
ES4DWheel
ES4DM5 Spacer x 2
ES4DM5 Bolt 40mm_prop
