Monolithcreative/ES4D/(list of files, cad)

Other CAD files:
3DP V1.1 Solidworks Files/ES4DSS-5GL_4.sldprt
3DP V1.1 Solidworks Files/ES4DSS-5GL.sldprt
3DP V1.1 Solidworks Files/ES4DSMPS BIG_LRS-350-24_24.sldprt
3DP V1.1 Solidworks Files/ES4DSS-5GL_3.sldprt
3DP V1.1 Solidworks Files/ES4DSMPS BIG_LRS-350-24_28.sldprt
3DP V1.1 Solidworks Files/ES4DSS-5GL_5.sldprt
3DP V1.1 Solidworks Files/ES4DSMPS BIG_LRS-350-24_27.sldprt
3DP V1.1 Solidworks Files/ES4DSMPS BIG_LRS-350-24_26.sldprt
3DP V1.1 Solidworks Files/ES4DSMPS BIG_LRS-350-24_22.sldprt
3DP V1.1 Solidworks Files/ES4DSMPS BIG_LRS-350-24_23.sldprt
3DP V1.1 Solidworks Files/ES4DSS-5GL_1.sldprt
3DP V1.1 Solidworks Files/ES4DSS-5GL_2.sldprt
3DP V1.1 Solidworks Files/ES4DSMPS BIG_LRS-350-24_25.sldprt
3DP V1.1 Solidworks Files/ES4DFan-Frame.sldprt
3DP V1.1 Solidworks Files/ES4DSMPS BIG_LRS-350-24_12.sldprt
3DP V1.1 Solidworks Files/ES4DSMPS BIG_LRS-350-24_18.sldprt
3DP V1.1 Solidworks Files/ES4DSMPS BIG_LRS-350-24_2.sldprt
3DP V1.1 Solidworks Files/ES4DSMPS BIG_LRS-350-24_4.sldprt
3DP V1.1 Solidworks Files/ES4DSMPS BIG_LRS-350-24_5.sldprt
3DP V1.1 Solidworks Files/ES4DSMPS BIG_LRS-350-24_20.sldprt
3DP V1.1 Solidworks Files/ES4DSMPS BIG_LRS-350-24_9.sldprt
3DP V1.1 Solidworks Files/ES4DSMPS BIG_LRS-350-24_7.sldprt
3DP V1.1 Solidworks Files/ES4DSMPS BIG_LRS-350-24_15.sldprt
3DP V1.1 Solidworks Files/ES4DSMPS BIG_LRS-350-24_6.sldprt
3DP V1.1 Solidworks Files/ES4DFan-Fan.sldprt
3DP V1.1 Solidworks Files/ES4DSMPS BIG_LRS-350-24_1.sldprt
3DP V1.1 Solidworks Files/ES4DSMPS BIG_LRS-350-24.sldprt
3DP V1.1 Solidworks Files/ES4DSMPS BIG_LRS-350-24_10.sldprt
3DP V1.1 Solidworks Files/ES4DSMPS BIG_LRS-350-24_8.sldprt
3DP V1.1 Solidworks Files/ES4DSMPS BIG_LRS-350-24_19.sldprt
3DP V1.1 Solidworks Files/ES4DSMPS BIG_LRS-350-24_14.sldprt
3DP V1.1 Solidworks Files/ES4DSMPS BIG_LRS-350-24_16.sldprt
3DP V1.1 Solidworks Files/ES4D40mmFan v3_1.sldprt
3DP V1.1 Solidworks Files/ES4DSMPS BIG_LRS-350-24_21.sldprt
3DP V1.1 Solidworks Files/ES4DSMPS BIG_LRS-350-24_17.sldprt
3DP V1.1 Solidworks Files/ES4DBearing Z_L.sldprt
3DP V1.1 Solidworks Files/ES4DSMPS BIG_LRS-350-24_13.sldprt
3DP V1.1 Solidworks Files/ES4DMotor Mount Z_L.sldprt
3DP V1.1 Solidworks Files/ES4DFan-Guard.sldprt
3DP V1.1 Solidworks Files/ES4DFan-Dempfer.sldprt
3DP V1.1 Solidworks Files/ES4DSMPS BIG_LRS-350-24_3.sldprt
3DP V1.1 Solidworks Files/ES4DSMPS BIG_LRS-350-24_11.sldprt
3DP V1.1 Solidworks Files/ES4D40mmFan v3.sldprt
3DP V1.1 Solidworks Files/ES4DM3 Bolt 16mm.SLDPRT
3DP V1.1 Solidworks Files/ES4DM3 Bolt 30mm.SLDPRT
3DP V1.1 Solidworks Files/ES4DM3 Bolt 8mm.SLDPRT
3DP V1.1 Solidworks Files/ES4DM5 Bolt 15mm_prop.SLDPRT
3DP V1.1 Solidworks Files/ES4DM5 Bolt 30mm.SLDPRT
3DP V1.1 Solidworks Files/ES4DM5 Bolt 30mm_prop.SLDPRT
3DP V1.1 Solidworks Files/ES4DM5 Bolt 40mm_prop.SLDPRT
3DP V1.1 Solidworks Files/ES4DM5 Bolt 75mm_prop.SLDPRT
3DP V1.1 Solidworks Files/ES4DM5 Offset nut.SLDPRT
3DP V1.1 Solidworks Files/ES4DM5 bolt.SLDPRT
3DP V1.1 Solidworks Files/ES4DT8 Nut.SLDPRT
3DP V1.1 Solidworks Files/ES4Dhex nut style 1_am_B18.2.4.1M - Hex nut, Style 1, M4 x 0.7 --D-N.sldprt
3DP V1.1 Solidworks Files/ES4Dsocket button head cap screw_am_B18.3.4M - 4 x 0.7 x 16 SBHCS --N.sldprt
